deniskokarev/aclock/hard/README.md

Schematics and Arduino UNO shield designed with DipTrace 2.4
http://diptrace.com/older-versions/
Should work with newer DipTrace 3.0 too

The board is intentionally designed single-sided to be suitable for DIY and fits the Nokia LCD screen component "natively"

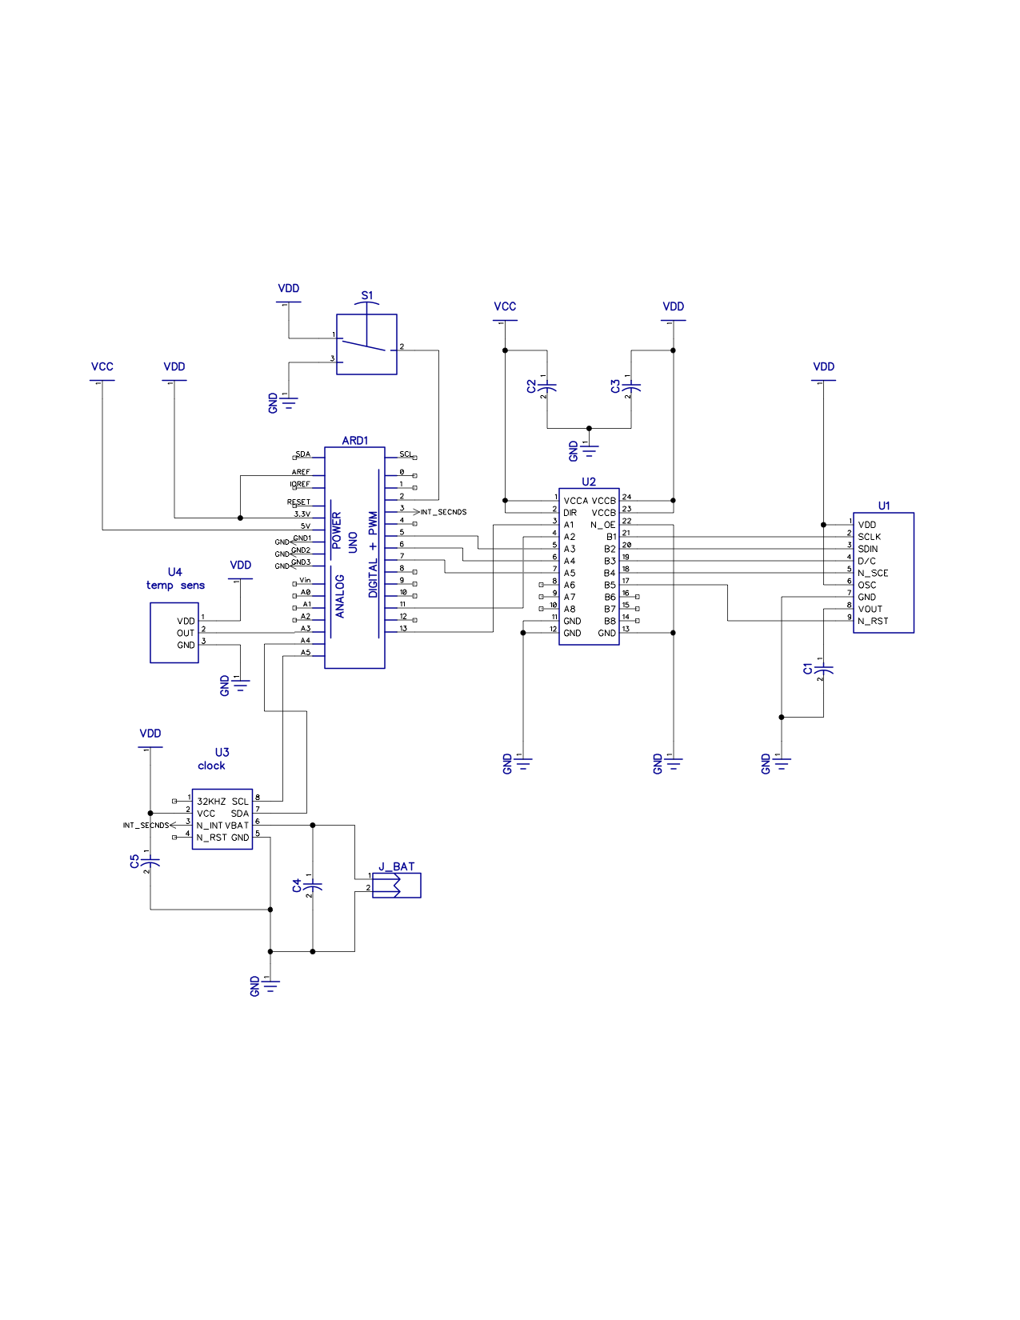
[picture p2: hard/aclock_schema.png]
Schematics
