deniskokarev/aclock/hard/aclock_pcb.pdf

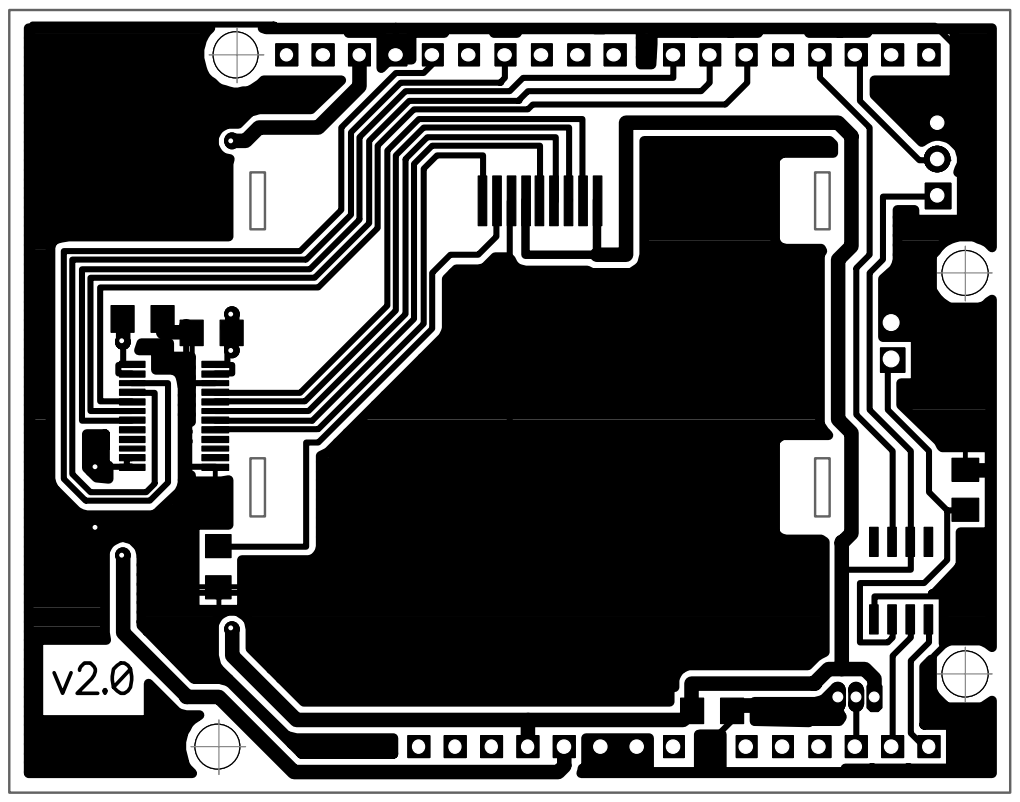
[picture p3: page 1]
