deniskokarev/aclock/(list of files, drawings)

Other design files:
hard/aclock.dch
hard/aclock.dip
