deniskokarev/aclock/(commit log)

2016-11-05 copied-in Arduino.mk and Common.mk
2016-11-05 first clock demo
    [aclock.dch, aclock.dip]
2016-11-05 adding temperature calculation
2016-11-06 adding setTime over serial interface upon RTC battery power loss
2016-11-06 minor bug fix and readme changes
    [aclock.ino]
2016-11-08 hardware v2.0 - moving DS3231 chip so that 1sec INT1 will be possible - adding a switch for C/F degrees display
    [aclock.dch, aclock.dip]
2016-11-20 2.0 board and Adafruit display library instead of SparkFun
    [aclock.dip]
2016-11-20 adding sleep/wakeup in rtc timer, optional temperature display in C or F
